carrola1/SpaceCenter/README.md

# Space_Center

## Lessons Learned
- Need to have GCC compiler optimization turned ON (optimize for size) for audio to work
-  tsl_user.h does not appear to be updating with Code Generation. Had to manually set Channel IOs definition (line 51)
