carrola1/SpaceCenter/Hardware/HLA_BOM.ods

Part # | Part Description | Qty | Cost Per | Cost Total | Notes
N/A | 3D Printed Star | 20 | $0.00 | $0.00
N/A | 3D Printed Rocket | 8 | $0.00 | $0.00
 | Push Button | 2 |  | $0.00
 | Toggle Switch |  |  | $0.00
N/A | Main PCBA | 1 | $124.00 | $124.00 | PCB + Components + Assembly
N/A | Touch PCBA | 30 | $1.13 | $34.00
N/A | Power Supply | 1 | $14.99 | $14.99 | Need 5-6A supply (184 LEDs at 20-30mA max each) Amazon: Aclorol 5V 6A 30W Power Supply
A05SR05SR30K305A | Touch Cables | 36 | $1.54 | $55.44 | Digi-key
J-Link EDU MINI | Programmer | 1 | $20.35 | $20.35
N/A | LED strip 144 LED/m | 1 | $21.00 | $21.00 | BTF-LIGHTING WS2812B RGB 5050SMD Individual Addressable 3.3FT
SK6812 | NeoPixels | 100 | $0.40 | $40.00 | Digi-key 1528-2388-ND (100 pack)
SRSS-TB(LF)(SN) | JST 5-POS Connectors | 100 | $0.40 | $40.00 | EBay. $32 + $8 shipping
3489 | Red arcade button with LED | 1 | $2.50 | $2.50 | Adafruit
3490 | Blue arcade button with LED | 1 | $2.50 | $2.50 | Adafruit
1314 | 3” speaker 4 ohm 3W | 2 | $1.95 | $3.90 | Adafruit
 |  |  | TOTAL | $358.68
