carrola1/SpaceCenter/Hardware/HLA_BOM.xlsx

Part # | Part Description | Qty | Cost Per | Cost Total | Notes
N/A | 3D Printed Star | 20 | $0.00 | $0.00
N/A | 3D Printed Rocket | 8 | $0.00 | $0.00
 | Push Button | 2 |  | $0.00
 | Toggle Switch |  |  | $0.00
N/A | Main PCBA | 1 | $124.00 | $124.00 | PCB + Components + Assembly
N/A | Touch PCBA | 20 |  | $0.00
N/A | LED Strip PCBA | 4 |  | $0.00
N/A | Power Supply | 1 | $14.99 | $14.99 | Need 5-6A supply (184 LEDs at 20-30mA max each) Amazon: Aclorol 5V 6A 30W Power Supply
A05SR05SR30K305B | Touch Cables | 32 | $1.52 | $48.64 | Digi-key
J-Link EDU MINI | Programmer | 1 | $20.35 | $20.35
LED Strip |  |  |  | $0.00 | 144 LEDs per meter. Need 128 LEDs total
 |  |  | TOTAL | $207.98
