carrola1/SpaceCenter/Hardware/SpaceCenter_MainBoard_KiCAD/SpaceCenter_MainBoard_BOM.xlsx

Item | Ref Des | Qty | Part # | Digi-key Part # | Value/Description | Package | Type | Instructions | DigiKey Cost (Each) | DigiKey Cost (Total)
1 | J6,J7,J8,J9,J10,J11,J12,J13,J14,J15,J16,J17,J18,J19,J20,J21,J22,J23,J24,J25,J26,J27,J28,J29,J30,J31,J32,J33, J34, J35,J36,J37,J38,J39,J40,J41 | 36 | DO NOT POPULATE | DO NOT POPULATE | Conn_01x05_Male | JST_SH_BM05B-SRSS-TB_1x05-1MP_P1.00mm_Vertical | SMD | DO NOT POPULATE | $0.73 | $26.28
2 | C1 | 1 | Basic | N/A | Ceramic 100u, 6.3V +/-20% or better | C_1206_3216Metric | SMD |  | $0.10 | $0.10
3 | C2,C7,C22,C23 | 4 | Basic | N/A | Ceramic 10u, 6.3V +/-20% or better | C_0603_1608Metric | SMD |  | $0.10 | $0.40
4 | C3 | 1 | Basic | N/A | Ceramic 1u, 6.3V +/-20% or better | C_0603_1608Metric | SMD |  | $0.10 | $0.10
5 | C4,C5,C6,C8,C9,C11,C12,C13,C14,C15,C16,C17,C18, C19,C20,C21,C24,C25,C26,C27 | 20 | Basic | N/A | Ceramic 0.1u 50V +/-10% or better | C_0603_1608Metric | SMD |  | $0.10 | $2.00
6 | C10 | 1 | Basic | N/A | Ceramic 0.01u 50V +/-10% or better | C_0603_1608Metric | SMD |  | $0.10 | $0.10
7 | D1 | 1 | LTST-C191KGKT | 160-1446-1-ND | LED | LED_0603_1608Metric | SMD |  | $0.26 | $0.26
8 | H1,H2,H3,H4 | 4 | N/A | N/A | MountingHole | MountingHole_3.2mm_M3 | SMD |  | N/A | N/A
9 | J1 | 1 | PJ-102AH | CP-102AH-ND | Barrel_Jack_Switch | BarrelJack_CUI_PJ-102AH_Horizontal | SMD |  | $0.76 | $0.76
10 | J2 | 1 | 20021121-00010C4LF | 609-3695-1-ND | Conn_ARM_JTAG_SWD_10 | PinHeader_2x05_P1.27mm_Vertical_SMD | SMD |  | $0.83 | $0.83
11 | J3 | 1 | DM3AT-SF-PEJM5 | HR1964CT-ND | Micro_SD_Card_Det_Hirose_DM3AT | microSD_HC_Hirose_DM3AT-SF-PEJM5 | SMD |  | $2.50 | $2.50
12 | J4,J5 | 2 | 282834-2 | A98333-ND | Screw_Terminal_01x02 | TerminalBlock_TE_282834-2_1x02_P2.54mm_Horizontal | THT | Screw terminals face out (toward edge of PCB) | $1.27 | $2.54
13 | J42 | 1 | 61300211121 | 732-5315-ND | Conn_01x02_Male | PinHeader_1x02_P2.54mm_Vertical | THT | Equivalent part # is acceptable | $0.13 | $0.13
14 | Q1,Q2 | 2 | DMG1012T-7 | DMG1012T-7DICT-ND | MOSFET N-CH 20V 630MA | SOT-523 | SMD |  | $0.31 | $0.62
15 | R1,R4,R6,R21,R23,R24,R26,R27 | 8 | Basic | N/A | 10k | R_0603_1608Metric | SMD |  | $0.10 | $0.80
16 | R2 | 1 | Basic | N/A | 100k | R_0603_1608Metric | SMD |  | $0.10 | $0.10
17 | R3,R5,R12,R13,R14,R15 | 6 | DO NOT POPULATE | N/A | DNP | R_0603_1608Metric | SMD | DO NOT POPULATE | $0.10 | $0.60
18 | R7,R22,R25 | 3 | Basic | N/A | 121 | R_0603_1608Metric | SMD |  | $0.10 | $0.30
19 | R8,R9,R10,R11,R18,R19,R20 | 7 | Basic | N/A | 33.2 | R_0603_1608Metric | SMD |  | $0.10 | $0.70
20 | R16,R17 | 2 | Basic | N/A | 200k | R_0603_1608Metric | SMD |  | $0.10 | $0.20
21 | TP1,TP2,TP3,TP4,TP5,TP6,TP7,TP8 | 8 | DO NOT POPULATE | N/A | TestPoint | TestPoint_Keystone_5019_Minature | SMD | DO NOT POPULATE | $0.10 | $0.80
22 | U1 | 1 | MIC5205-3.3YM5-TR | 576-1259-1-ND | IC REG LINEAR 3.3V 150MA | SOT-23-5 | SMD |  | $0.42 | $0.42
23 | U2 | 1 | STM32L072VBT6 | 497-18582-ND | IC MCU 32BIT 128KB FLASH | LQFP-100_14x14mm_P0.5mm | SMD |  | $6.03 | $6.03
24 | U3,U4 | 2 | MAX98357AETE+T | MAX98357AETE+TCT-ND | IC AMP CLASS D MONO 3.2W | QFN50P300X300X80-17N | SMD |  | $2.44 | $4.88
25 | U5,U6 | 2 | SN74LVC2T45DCUR | 296-17014-1-ND | SN74LVC2T45DCUR | VSSOP-8_2.4x2.1mm_P0.5mm | SMD |  | $0.63 | $1.26
 |  |  |  |  |  |  |  |  |  | $52.71
 |  | 60
