carrola1/SpaceCenter/Hardware/3D Prints/SpaceCenter Rocket.stl

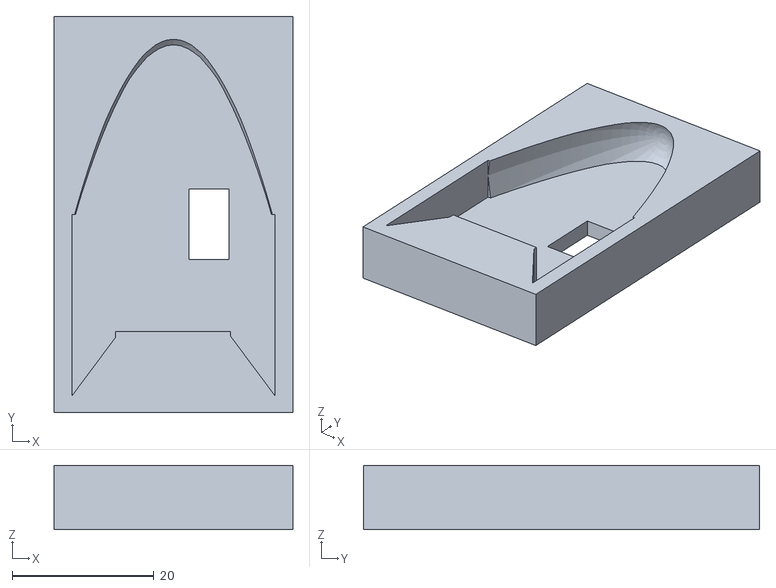
[picture p1: CAD file, 2021-08-10]
Hardware/3D Prints/SpaceCenter Rocket.stl
33.7 x 55.9 x 9.07
