carrola1/SpaceCenter/Hardware/SpaceCenter_TouchBoard_KiCAD_Rev2/SpaceCenter_TouchBoard_KiCAD.step

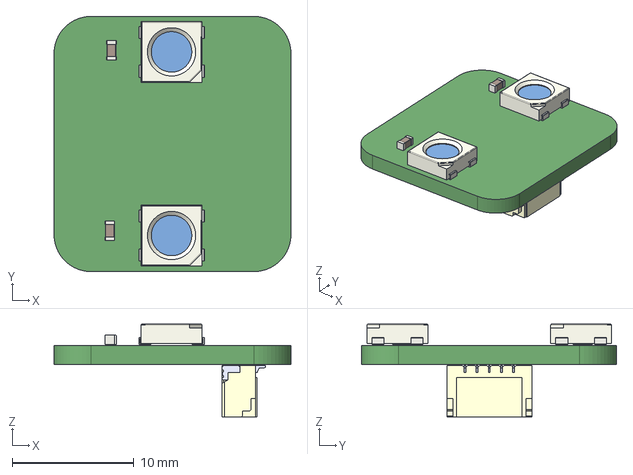
[picture p2: CAD file, 2021-05-17]
Hardware/SpaceCenter_TouchBoard_KiCAD_Rev2/SpaceCenter_TouchBoard_KiCAD.step
19.5 x 21.0 x 7.65 mm
