carrola1/SpaceCenter/Hardware/3D Prints/SpaceCenter Rocket Tall.stl

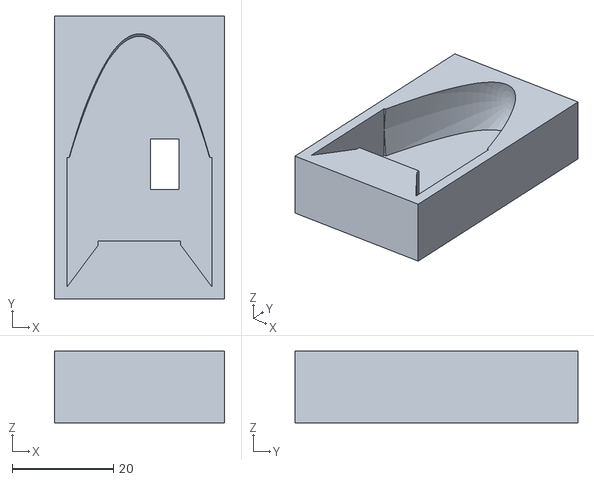
[picture p3: CAD file, 2021-08-10]
Hardware/3D Prints/SpaceCenter Rocket Tall.stl
33.7 x 55.9 x 14.1
