carrola1/SpaceCenter/Hardware/3D Prints/Space Center Star.3mf

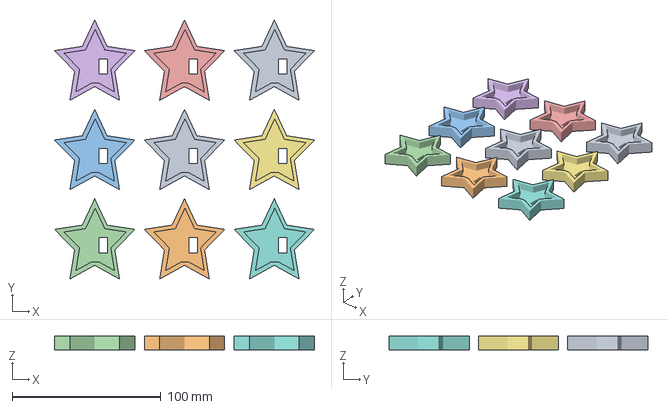
[picture p5: CAD file, 2021-06-10]
Hardware/3D Prints/Space Center Star.3mf
174.5 x 173.9 x 9.07 mm
