carrola1/SpaceCenter/Hardware/3D Prints/SpaceCenter Rocket Stream LED Holder.stl

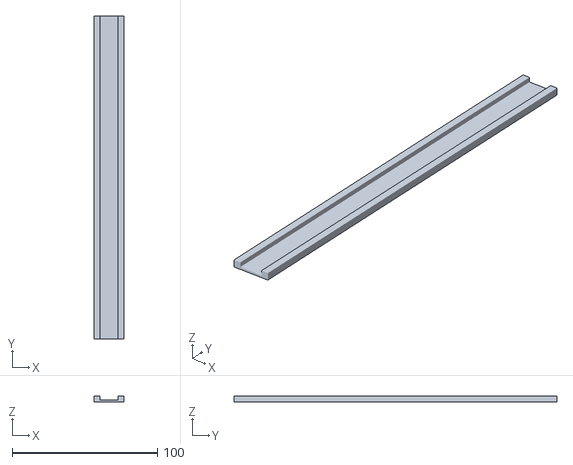
[picture p6: CAD file, 2021-06-10]
Hardware/3D Prints/SpaceCenter Rocket Stream LED Holder.stl
20.3 x 222.2 x 3.81
