carrola1/SpaceCenter/(list of files, cad)

Other CAD files:
Hardware/3D Prints/Space Center Star.stl
