carrola1/SpaceCenter/Hardware/SpaceCenter_TouchBoard_KiCAD_Rev2/SpaceCenter_TouchBoard_KiCAD.kicad_pcb

## KiCad design Hardware/SpaceCenter_TouchBoard_KiCAD_Rev2/SpaceCenter_TouchBoard_KiCAD.kicad_pcb (2021-10-01)

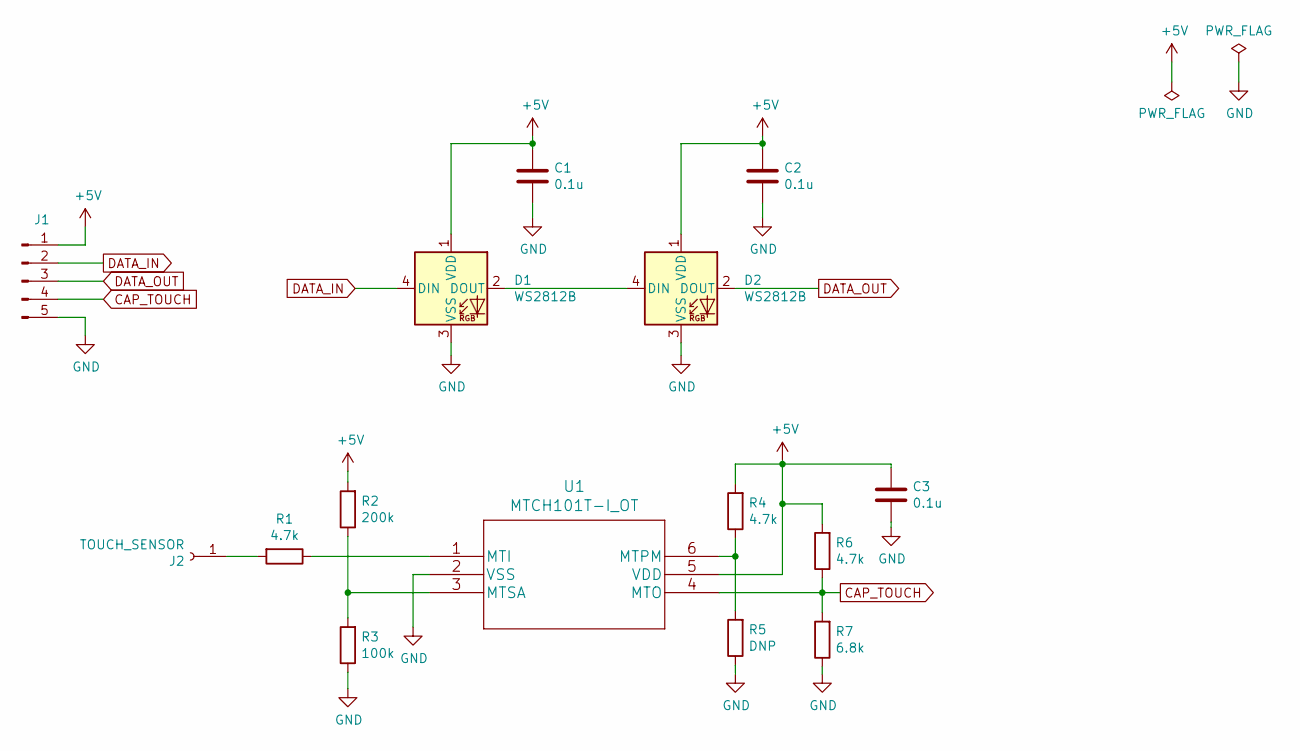
[picture p7: schematic SpaceCenter_TouchBoard_KiCAD.sch]

Parts:
C1, C2, C3: 0.1u; C_0402_1005Metric_Pad0.74x0.62mm_HandSolder
D1, D2: WS2812B; LED_WS2812B_PLCC4_5.0x5.0mm_P3.2mm
J1: Conn_01x05_Male; JST_SH_BM05B-SRSS-TB_1x05-1MP_P1.00mm_Vertical
J2: TOUCH_SENSOR; SolderWirePad_1x01_SMD_5x10mm
R1, R4, R6: 4.7k; R_0402_1005Metric_Pad0.72x0.64mm_HandSolder
R2: 200k; R_0402_1005Metric_Pad0.72x0.64mm_HandSolder
R3: 100k; R_0402_1005Metric_Pad0.72x0.64mm_HandSolder
R5: DNP; R_0402_1005Metric_Pad0.72x0.64mm_HandSolder
R7: 6.8k; R_0402_1005Metric_Pad0.72x0.64mm_HandSolder
U1: MTCH101T-I_OT; MTCH101T-I&slash_OT

Connections:
+5V: C1.1, C2.1, C3.1, D1.1 (VDD), D2.1 (VDD), J1.1, R2.2, R4.2, R6.2, U1.5 (VDD)
CAP_TOUCH: J1.4, R6.1, R7.2, U1.4 (MTO)
DATA_IN: D1.4 (DIN), J1.2
DATA_OUT: D2.2 (DOUT), J1.3
GND: C1.2, C2.2, C3.2, D1.3 (VSS), D2.3 (VSS), J1.5, R3.1, R5.1, R7.1, U1.2 (VSS)
unnamed: D1.2 (DOUT), D2.4 (DIN)
unnamed: J2.1, R1.2
unnamed: R1.1, U1.1 (MTI)
unnamed: R2.1, R3.2, U1.3 (MTSA)
unnamed: R4.1, R5.2, U1.6 (MTPM)

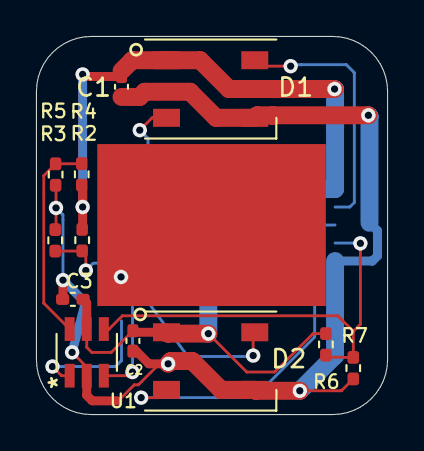
[picture p8: board SpaceCenter_TouchBoard_KiCAD.kicad_pcb from above]

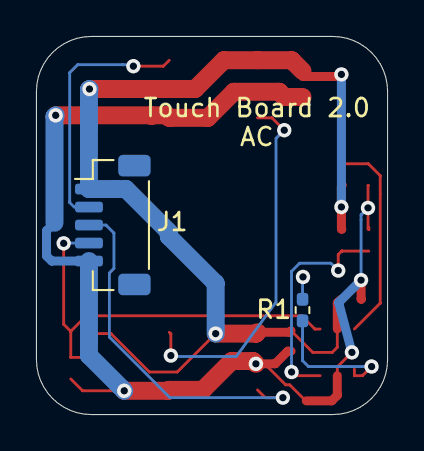
[picture p9: board SpaceCenter_TouchBoard_KiCAD.kicad_pcb from below]

Board: 2 copper layers, 19.5 x 21.0 mm, 15 parts (2 on the bottom side), 10 nets.
