carrola1/SpaceCenter/Hardware/SpaceCenter_MainBoard_KiCAD/SpaceCenter_MainBoard_KiCAD.kicad_pcb

## KiCad design Hardware/SpaceCenter_MainBoard_KiCAD/SpaceCenter_MainBoard_KiCAD.kicad_pcb (2021-02-16)

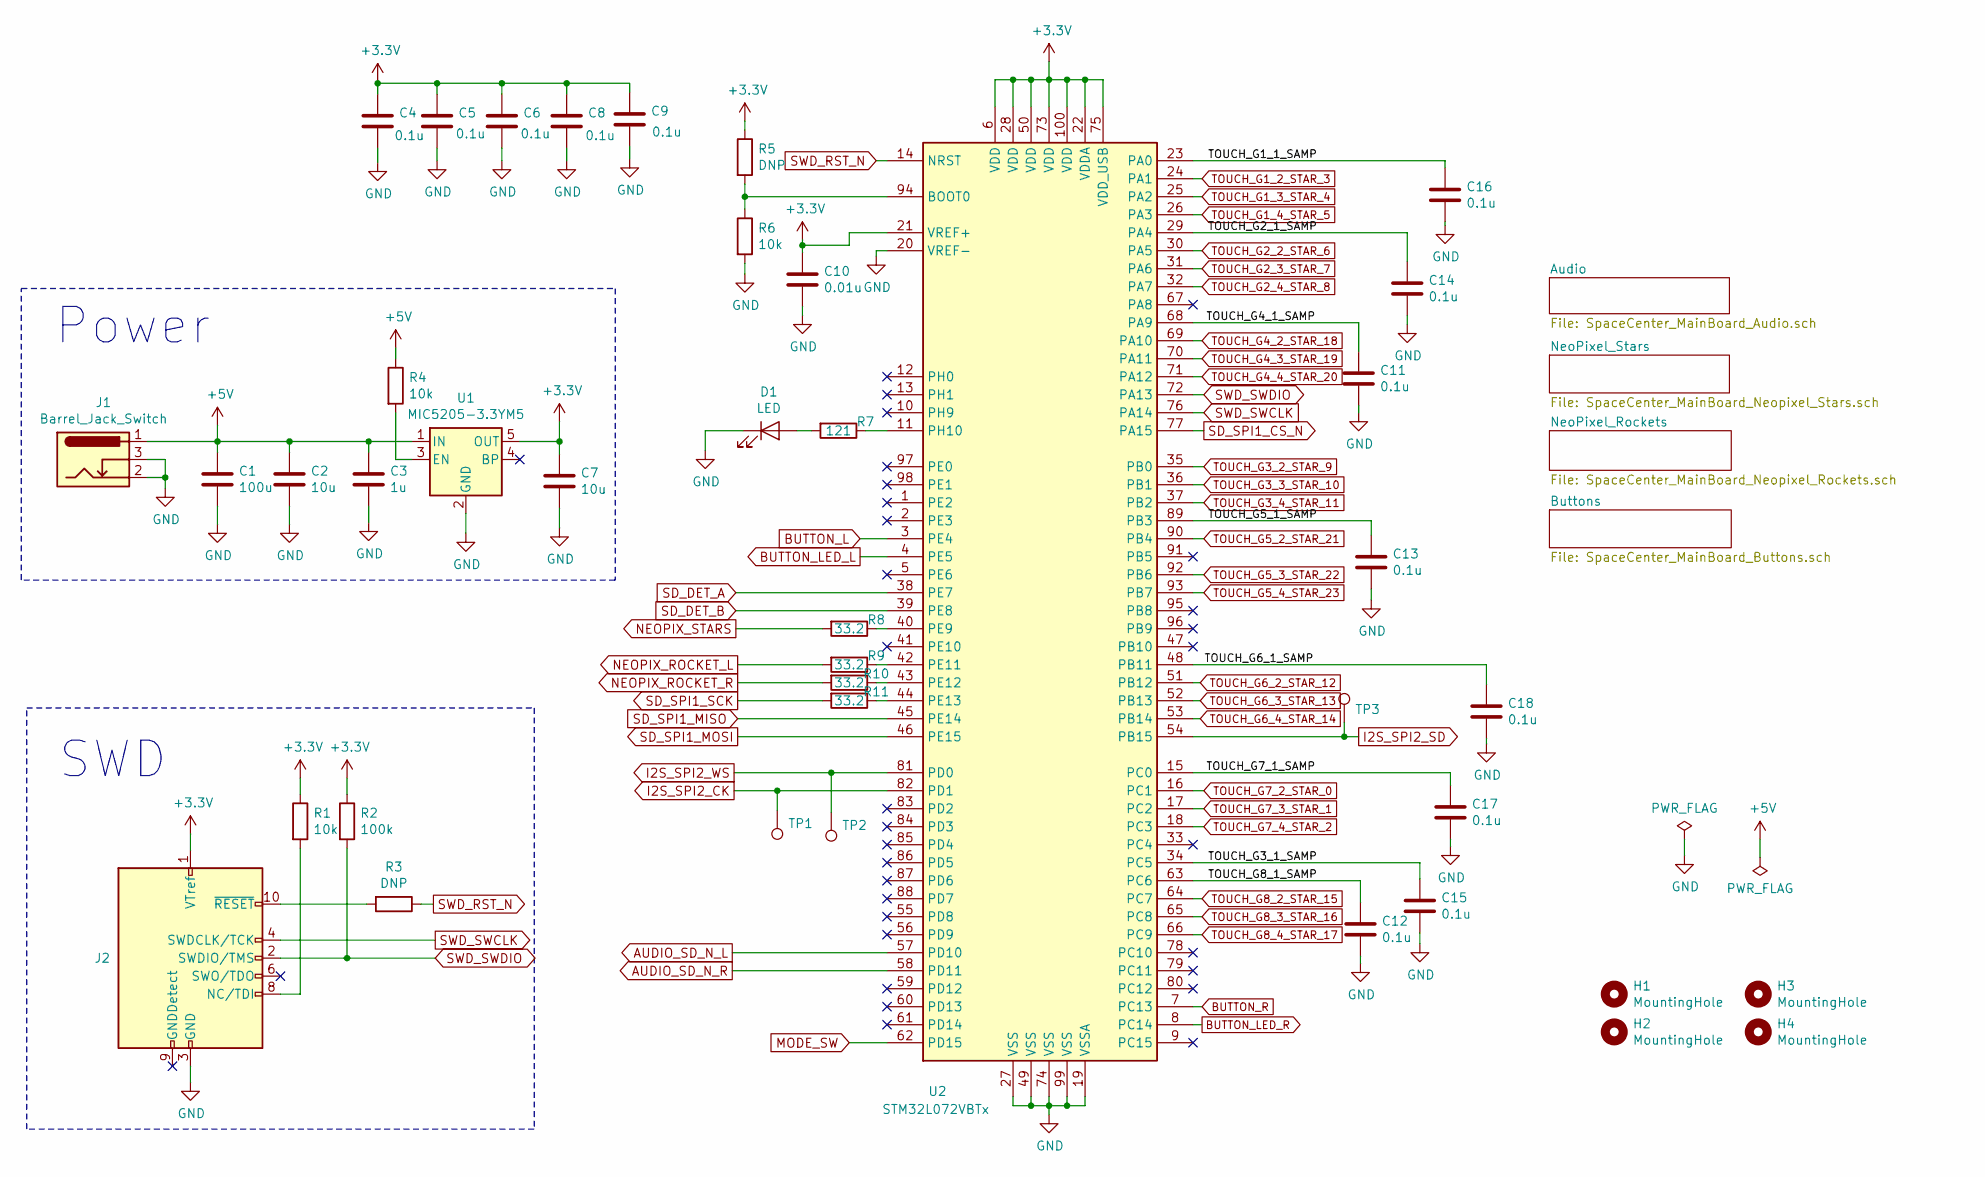
[picture p10: schematic SpaceCenter_MainBoard_KiCAD.sch]

Parts:
C1: 100u; C_1206_3216Metric_Pad1.42x1.75mm_HandSolder
C2, C7: 10u; C_0603_1608Metric_Pad1.05x0.95mm_HandSolder
C3: 1u; C_0603_1608Metric_Pad1.05x0.95mm_HandSolder
C4, C5, C6, C8, C9, C11, C12, C13, C14, C15, C16, C17, C18: 0.1u; C_0603_1608Metric_Pad1.05x0.95mm_HandSolder
C10: 0.01u; C_0603_1608Metric_Pad1.05x0.95mm_HandSolder
D1: LED; LED_0603_1608Metric_Pad1.05x0.95mm_HandSolder
H1, H2, H3, H4: MountingHole; MountingHole_3.2mm_M3
J1: Barrel_Jack_Switch; BarrelJack_CUI_PJ-102AH_Horizontal
J2: Conn_ARM_JTAG_SWD_10; PinHeader_2x05_P1.27mm_Vertical_SMD
R1, R4, R6: 10k; R_0603_1608Metric_Pad1.05x0.95mm_HandSolder
R2: 100k; R_0603_1608Metric_Pad1.05x0.95mm_HandSolder
R3, R5: DNP; R_0603_1608Metric_Pad1.05x0.95mm_HandSolder
R7: 121; R_0603_1608Metric_Pad1.05x0.95mm_HandSolder
R8, R9, R10, R11: 33.2; R_0603_1608Metric_Pad1.05x0.95mm_HandSolder
TP1, TP2, TP3: TestPoint; TestPoint_Keystone_5019_Minature
U1: MIC5205-3.3YM5; SOT-23-5
U2: STM32L072VBTx; LQFP-100_14x14mm_P0.5mm

Connections:
+3V3: C4.1, C5.1, C6.1, C7.1, C8.1, C9.1, C10.1, J2.1 (VTref), R1.1, R2.1, R5.1, U1.5 (OUT), U2.6 (VDD), U2.21 (VREF+), U2.22 (VDDA), U2.28 (VDD), U2.50 (VDD), U2.73 (VDD), U2.75 (VDD_USB), U2.100 (VDD); also elsewhere on the board
+5V: C1.1, C2.1, C3.1, J1.1, R4.1, U1.1 (IN); also elsewhere on the board
/TOUCH_G1_1_SAMP: C16.1, U2.23 (PA0)
/TOUCH_G2_1_SAMP: C14.1, U2.29 (PA4)
/TOUCH_G3_1_SAMP: C15.1, U2.34 (PC5)
/TOUCH_G4_1_SAMP: C11.1, U2.68 (PA9)
/TOUCH_G5_1_SAMP: C13.1, U2.89 (PB3)
/TOUCH_G6_1_SAMP: C18.1, U2.48 (PB11)
/TOUCH_G7_1_SAMP: C17.1, U2.15 (PC0)
/TOUCH_G8_1_SAMP: C12.1, U2.63 (PC6)
AUDIO_SD_N_L: U2.57 (PD10); also elsewhere on the board
AUDIO_SD_N_R: U2.58 (PD11); also elsewhere on the board
BUTTON_L: U2.3 (PE4); also elsewhere on the board
BUTTON_LED_L: U2.4 (PE5); also elsewhere on the board
BUTTON_LED_R: U2.8 (PC14); also elsewhere on the board
BUTTON_R: U2.7 (PC13); also elsewhere on the board
GND: C1.2, C2.2, C3.2, C4.2, C5.2, C6.2, C7.2, C8.2, C9.2, C10.2, C11.2, C12.2, C13.2, C14.2, C15.2, C16.2, C17.2, C18.2, D1.1 (K), J1.2, J1.3, J2.3 (GND), J2.5 (GND), R6.2, U1.2 (GND), U2.19 (VSSA), U2.20 (VREF-), U2.27 (VSS), U2.49 (VSS), U2.74 (VSS), U2.99 (VSS); also elsewhere on the board
I2S_SPI2_CK: TP1.1, U2.82 (PD1); also elsewhere on the board
I2S_SPI2_SD: TP3.1, U2.54 (PB15); also elsewhere on the board
I2S_SPI2_WS: TP2.1, U2.81 (PD0); also elsewhere on the board
MODE_SW: U2.62 (PD15); also elsewhere on the board
NEOPIX_ROCKET_L: R9.2; also elsewhere on the board
NEOPIX_ROCKET_R: R10.2; also elsewhere on the board
NEOPIX_STARS: R8.2; also elsewhere on the board
unnamed: D1.2 (A), R7.2
unnamed: J2.8 (NC/TDI), R1.2
unnamed: J2.10 (~RESET~), R3.2
unnamed: R4.2, U1.3 (EN)
unnamed: R5.2, R6.1, U2.94 (BOOT0)
unnamed: R7.1, U2.11 (PH10)
unnamed: R8.1, U2.40 (PE9)
unnamed: R9.1, U2.42 (PE11)
unnamed: R10.1, U2.43 (PE12)
unnamed: R11.1, U2.44 (PE13)
SD_DET_A: U2.38 (PE7); also elsewhere on the board
SD_DET_B: U2.39 (PE8); also elsewhere on the board
SD_SPI1_CS_N: U2.77 (PA15); also elsewhere on the board
SD_SPI1_MISO: U2.45 (PE14); also elsewhere on the board
SD_SPI1_MOSI: U2.46 (PE15); also elsewhere on the board
SD_SPI1_SCK: R11.2; also elsewhere on the board
SWD_RST_N: R3.1, U2.14 (NRST)
SWD_SWCLK: J2.4 (SWDCLK/TCK), U2.76 (PA14)
SWD_SWDIO: J2.2 (SWDIO/TMS), R2.2, U2.72 (PA13)
TOUCH_G1_2_STAR_3: U2.24 (PA1); also elsewhere on the board
TOUCH_G1_3_STAR_4: U2.25 (PA2); also elsewhere on the board
TOUCH_G1_4_STAR_5: U2.26 (PA3); also elsewhere on the board
TOUCH_G2_2_STAR_6: U2.30 (PA5); also elsewhere on the board
TOUCH_G2_3_STAR_7: U2.31 (PA6); also elsewhere on the board
TOUCH_G2_4_STAR_8: U2.32 (PA7); also elsewhere on the board
TOUCH_G3_2_STAR_9: U2.35 (PB0); also elsewhere on the board
TOUCH_G3_3_STAR_10: U2.36 (PB1); also elsewhere on the board
TOUCH_G3_4_STAR_11: U2.37 (PB2); also elsewhere on the board
TOUCH_G4_2_STAR_18: U2.69 (PA10); also elsewhere on the board
TOUCH_G4_3_STAR_19: U2.70 (PA11); also elsewhere on the board
TOUCH_G4_4_STAR_20: U2.71 (PA12); also elsewhere on the board
TOUCH_G5_2_STAR_21: U2.90 (PB4); also elsewhere on the board
TOUCH_G5_3_STAR_22: U2.92 (PB6); also elsewhere on the board
TOUCH_G5_4_STAR_23: U2.93 (PB7); also elsewhere on the board
TOUCH_G6_2_STAR_12: U2.51 (PB12); also elsewhere on the board
TOUCH_G6_3_STAR_13: U2.52 (PB13); also elsewhere on the board
TOUCH_G6_4_STAR_14: U2.53 (PB14); also elsewhere on the board
TOUCH_G7_2_STAR_0: U2.16 (PC1); also elsewhere on the board
TOUCH_G7_3_STAR_1: U2.17 (PC2); also elsewhere on the board
TOUCH_G7_4_STAR_2: U2.18 (PC3); also elsewhere on the board
TOUCH_G8_2_STAR_15: U2.64 (PC7); also elsewhere on the board
TOUCH_G8_3_STAR_16: U2.65 (PC8); also elsewhere on the board
TOUCH_G8_4_STAR_17: U2.66 (PC9); also elsewhere on the board

Notes on the sheet:
Power
SWD

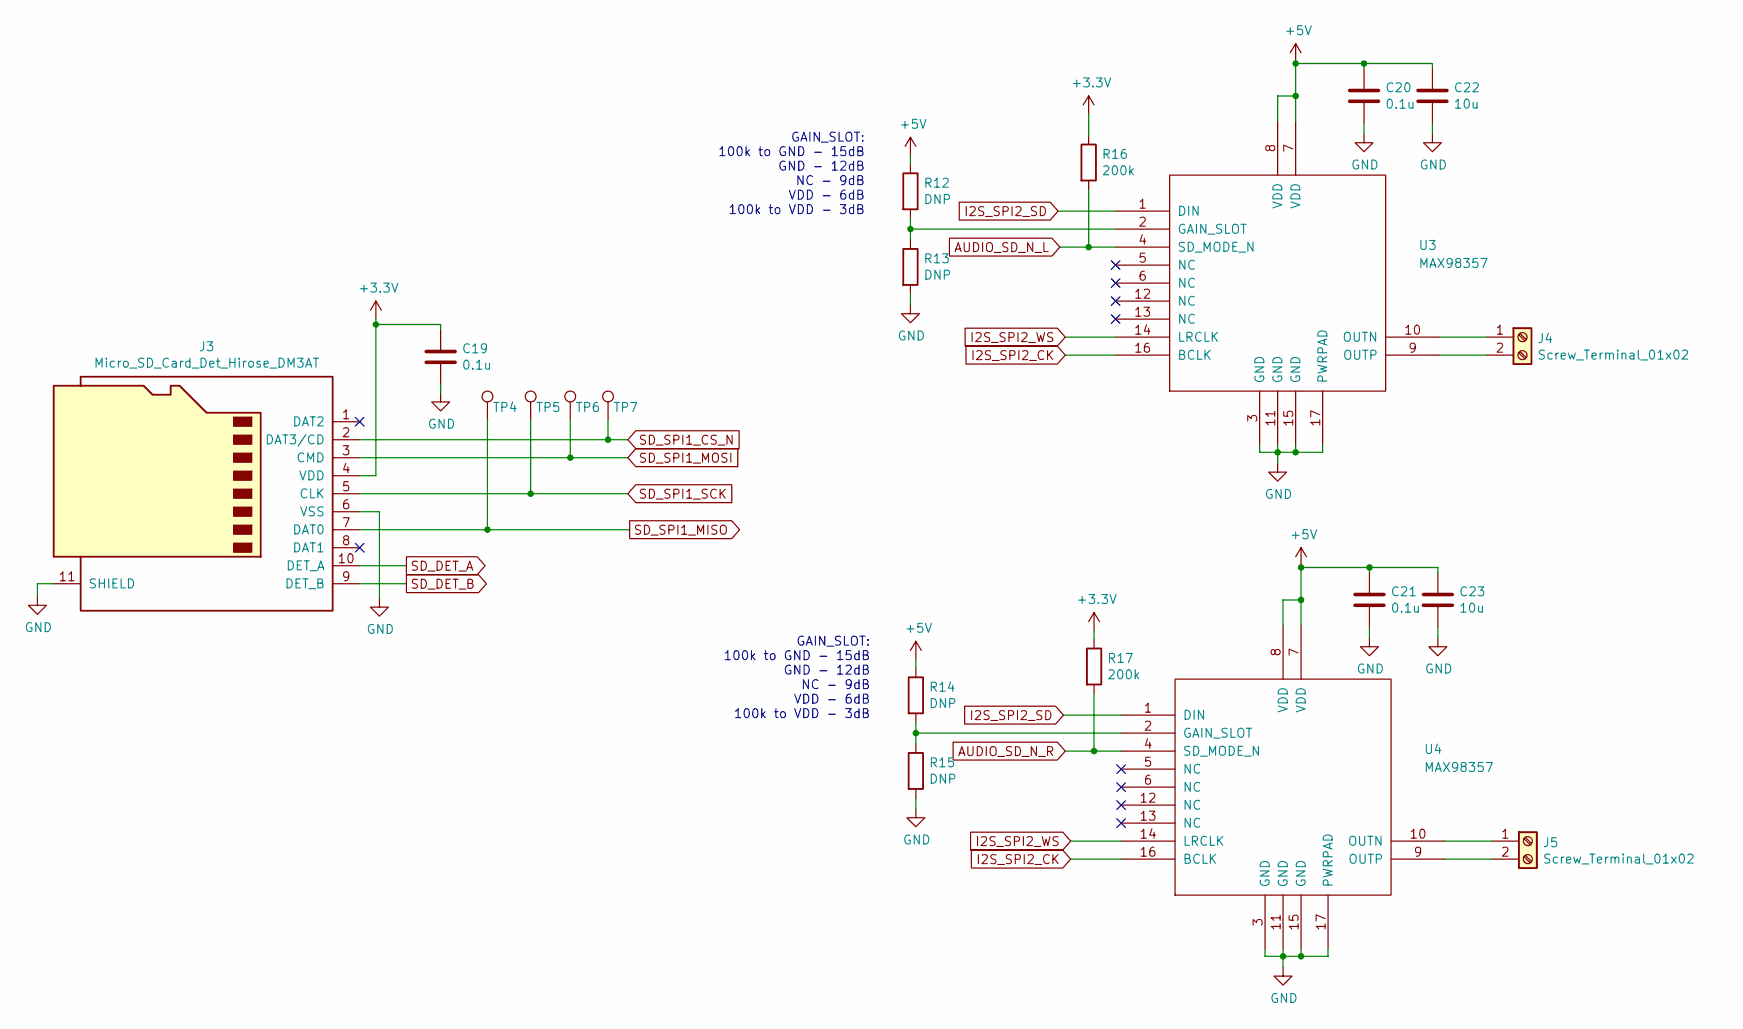
[picture p11: schematic SpaceCenter_MainBoard_Audio.sch]

Parts:
C19, C20, C21: 0.1u; C_0603_1608Metric_Pad1.05x0.95mm_HandSolder
C22, C23: 10u; C_0603_1608Metric_Pad1.05x0.95mm_HandSolder
J3: Micro_SD_Card_Det_Hirose_DM3AT; microSD_HC_Hirose_DM3AT-SF-PEJM5
J4, J5: Screw_Terminal_01x02; TerminalBlock_TE_282834-2_1x02_P2.54mm_Horizontal
R12, R13, R14, R15: DNP; R_0603_1608Metric_Pad1.05x0.95mm_HandSolder
R16, R17: 200k; R_0603_1608Metric_Pad1.05x0.95mm_HandSolder
TP4, TP5, TP6, TP7: TestPoint; TestPoint_Keystone_5019_Minature
U3, U4: MAX98357; QFN50P300X300X80-17N

Connections:
+3V3: C19.1, J3.4 (VDD), R16.1, R17.1; also elsewhere on the board
+5V: C20.1, C21.1, C22.1, C23.1, R12.1, R14.1, U3.7 (VDD), U3.8 (VDD), U4.7 (VDD), U4.8 (VDD); also elsewhere on the board
AUDIO_SD_N_L: R16.2, U3.4 (SD_MODE_N); also elsewhere on the board
AUDIO_SD_N_R: R17.2, U4.4 (SD_MODE_N); also elsewhere on the board
GND: C19.2, C20.2, C21.2, C22.2, C23.2, J3.6 (VSS), J3.11 (SHIELD), R13.2, R15.2, U3.3 (GND), U3.11 (GND), U3.15 (GND), U3.17 (PWRPAD), U4.3 (GND), U4.11 (GND), U4.15 (GND), U4.17 (PWRPAD); also elsewhere on the board
I2S_SPI2_CK: U3.16 (BCLK), U4.16 (BCLK); also elsewhere on the board
I2S_SPI2_SD: U3.1 (DIN), U4.1 (DIN); also elsewhere on the board
I2S_SPI2_WS: U3.14 (LRCLK), U4.14 (LRCLK); also elsewhere on the board
unnamed: J4.1, U3.10 (OUTN)
unnamed: J4.2, U3.9 (OUTP)
unnamed: J5.1, U4.10 (OUTN)
unnamed: J5.2, U4.9 (OUTP)
unnamed: R12.2, R13.1, U3.2 (GAIN_SLOT)
unnamed: R14.2, R15.1, U4.2 (GAIN_SLOT)
SD_DET_A: J3.10 (DET_A); also elsewhere on the board
SD_DET_B: J3.9 (DET_B); also elsewhere on the board
SD_SPI1_CS_N: J3.2 (DAT3/CD), TP7.1; also elsewhere on the board
SD_SPI1_MISO: J3.7 (DAT0), TP4.1; also elsewhere on the board
SD_SPI1_MOSI: J3.3 (CMD), TP6.1; also elsewhere on the board
SD_SPI1_SCK: J3.5 (CLK), TP5.1; also elsewhere on the board

Notes on the sheet:
GAIN_SLOT: 100k to GND - 15dB GND - 12dB NC - 9dB VDD - 6dB 100k to VDD - 3dB

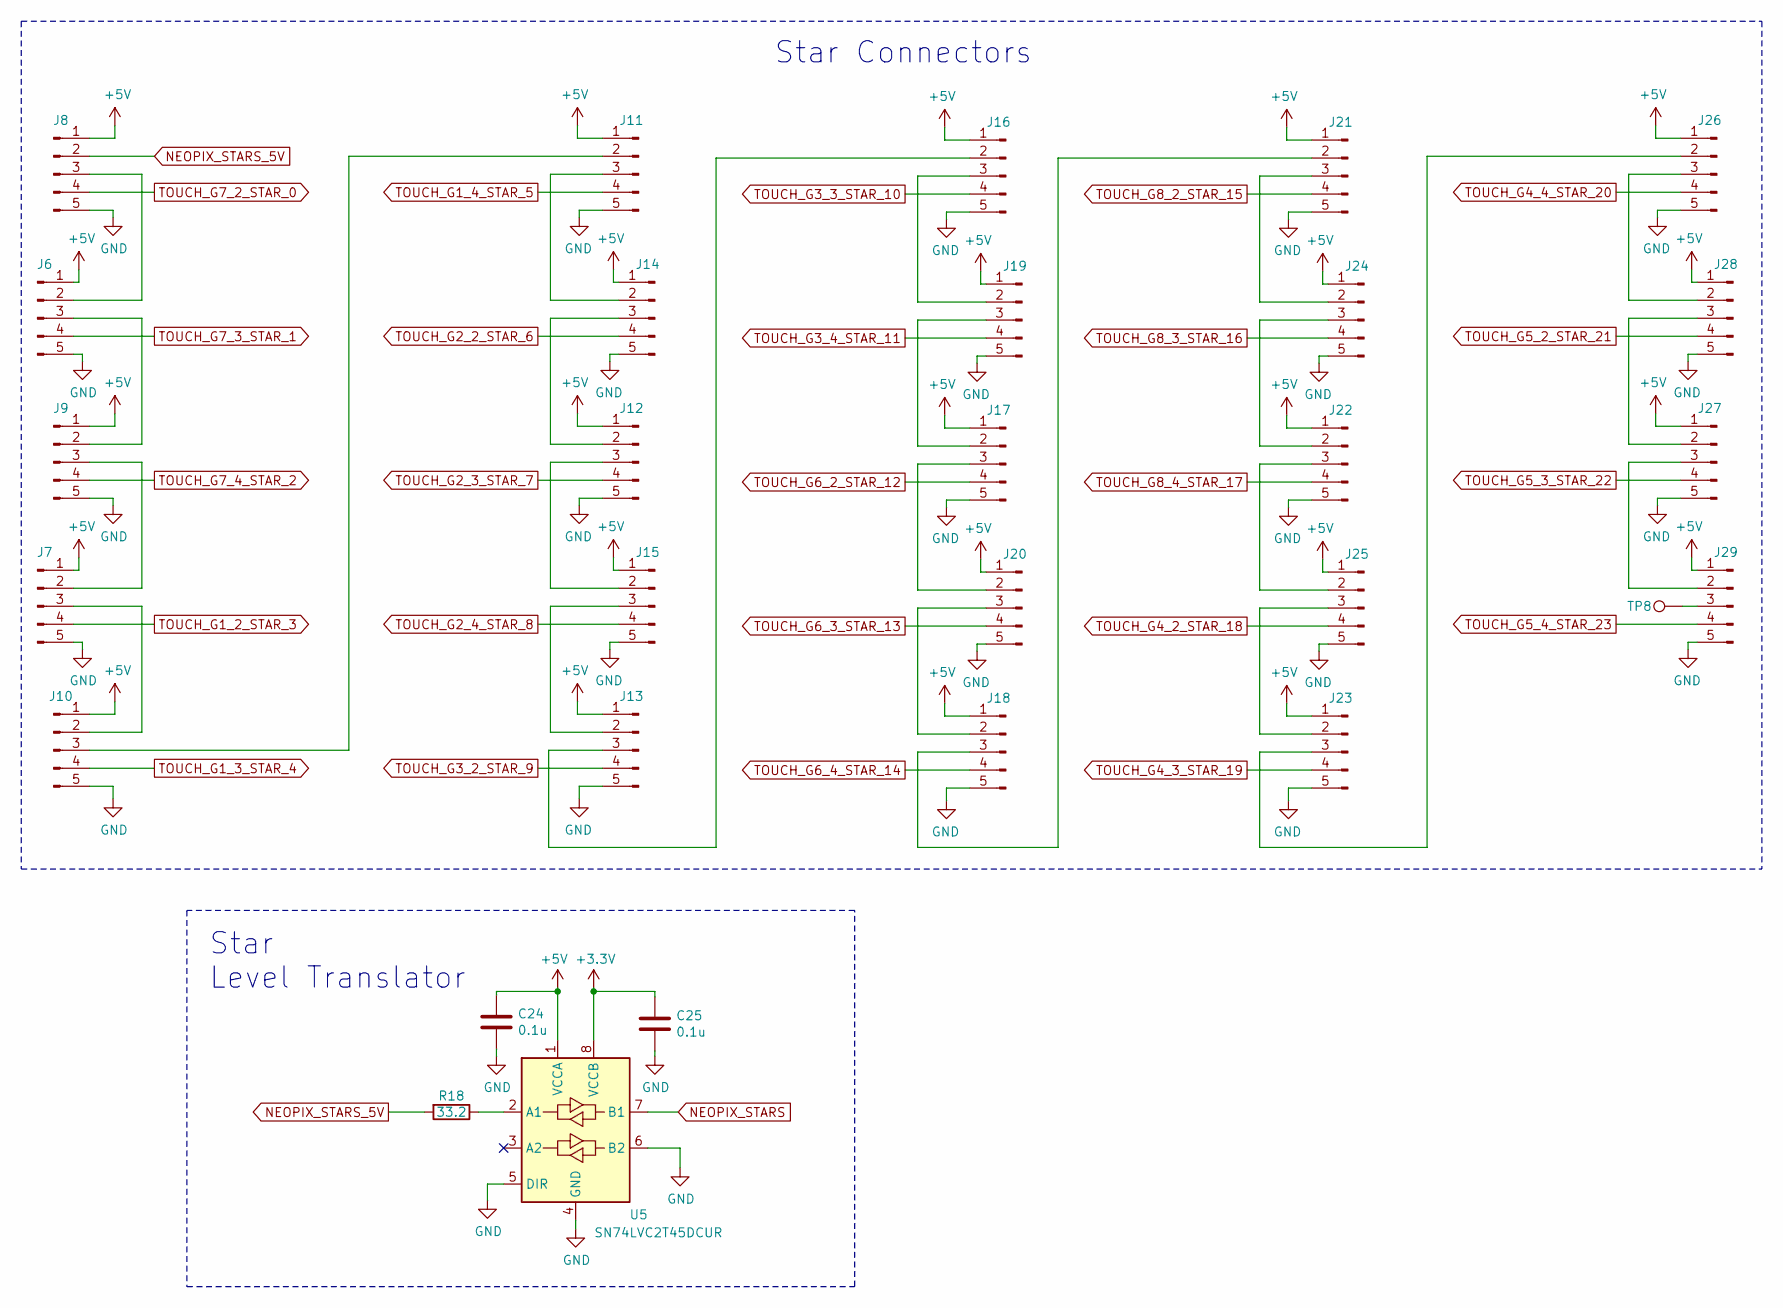
[picture p12: schematic SpaceCenter_MainBoard_Neopixel_Stars.sch]

Parts:
C24, C25: 0.1u; C_0603_1608Metric_Pad1.05x0.95mm_HandSolder
J6, J7, J8, J9, J10, J11, J12, J13, J14, J15, J16, J17, J18, J19, J20, J21, J22, J23, J24, J25, J26, J27, J28, J29: Conn_01x05_Male; JST_SH_BM05B-SRSS-TB_1x05-1MP_P1.00mm_Vertical
R18: 33.2; R_0603_1608Metric_Pad1.05x0.95mm_HandSolder
TP8: TestPoint; TestPoint_Keystone_5019_Minature
U5: SN74LVC2T45DCUR; VSSOP-8_2.4x2.1mm_P0.5mm

Connections:
+3V3: C25.1, U5.8 (VCCB); also elsewhere on the board
+5V: C24.1, J6.1, J7.1, J8.1, J9.1, J10.1, J11.1, J12.1, J13.1, J14.1, J15.1, J16.1, J17.1, J18.1, J19.1, J20.1, J21.1, J22.1, J23.1, J24.1, J25.1, J26.1, J27.1, J28.1, J29.1, U5.1 (VCCA); also elsewhere on the board
GND: C24.2, C25.2, J6.5, J7.5, J8.5, J9.5, J10.5, J11.5, J12.5, J13.5, J14.5, J15.5, J16.5, J17.5, J18.5, J19.5, J20.5, J21.5, J22.5, J23.5, J24.5, J25.5, J26.5, J27.5, J28.5, J29.5, U5.4 (GND), U5.5 (DIR), U5.6 (B2); also elsewhere on the board
NEOPIX_STARS: U5.7 (B1); also elsewhere on the board
NEOPIX_STARS_5V: J8.2, R18.2
unnamed: J6.2, J8.3
unnamed: J6.3, J9.2
unnamed: J7.2, J9.3
unnamed: J7.3, J10.2
unnamed: J10.3, J11.2
unnamed: J11.3, J14.2
unnamed: J12.2, J14.3
unnamed: J12.3, J15.2
unnamed: J13.2, J15.3
unnamed: J13.3, J16.2
unnamed: J16.3, J19.2
unnamed: J17.2, J19.3
unnamed: J17.3, J20.2
unnamed: J18.2, J20.3
unnamed: J18.3, J21.2
unnamed: J21.3, J24.2
unnamed: J22.2, J24.3
unnamed: J22.3, J25.2
unnamed: J23.2, J25.3
unnamed: J23.3, J26.2
unnamed: J26.3, J28.2
unnamed: J27.2, J28.3
unnamed: J27.3, J29.2
unnamed: J29.3, TP8.1
unnamed: R18.1, U5.2 (A1)
TOUCH_G1_2_STAR_3: J7.4; also elsewhere on the board
TOUCH_G1_3_STAR_4: J10.4; also elsewhere on the board
TOUCH_G1_4_STAR_5: J11.4; also elsewhere on the board
TOUCH_G2_2_STAR_6: J14.4; also elsewhere on the board
TOUCH_G2_3_STAR_7: J12.4; also elsewhere on the board
TOUCH_G2_4_STAR_8: J15.4; also elsewhere on the board
TOUCH_G3_2_STAR_9: J13.4; also elsewhere on the board
TOUCH_G3_3_STAR_10: J16.4; also elsewhere on the board
TOUCH_G3_4_STAR_11: J19.4; also elsewhere on the board
TOUCH_G4_2_STAR_18: J25.4; also elsewhere on the board
TOUCH_G4_3_STAR_19: J23.4; also elsewhere on the board
TOUCH_G4_4_STAR_20: J26.4; also elsewhere on the board
TOUCH_G5_2_STAR_21: J28.4; also elsewhere on the board
TOUCH_G5_3_STAR_22: J27.4; also elsewhere on the board
TOUCH_G5_4_STAR_23: J29.4; also elsewhere on the board
TOUCH_G6_2_STAR_12: J17.4; also elsewhere on the board
TOUCH_G6_3_STAR_13: J20.4; also elsewhere on the board
TOUCH_G6_4_STAR_14: J18.4; also elsewhere on the board
TOUCH_G7_2_STAR_0: J8.4; also elsewhere on the board
TOUCH_G7_3_STAR_1: J6.4; also elsewhere on the board
TOUCH_G7_4_STAR_2: J9.4; also elsewhere on the board
TOUCH_G8_2_STAR_15: J21.4; also elsewhere on the board
TOUCH_G8_3_STAR_16: J24.4; also elsewhere on the board
TOUCH_G8_4_STAR_17: J22.4; also elsewhere on the board

Notes on the sheet:
Star Level Translator
Star Connectors

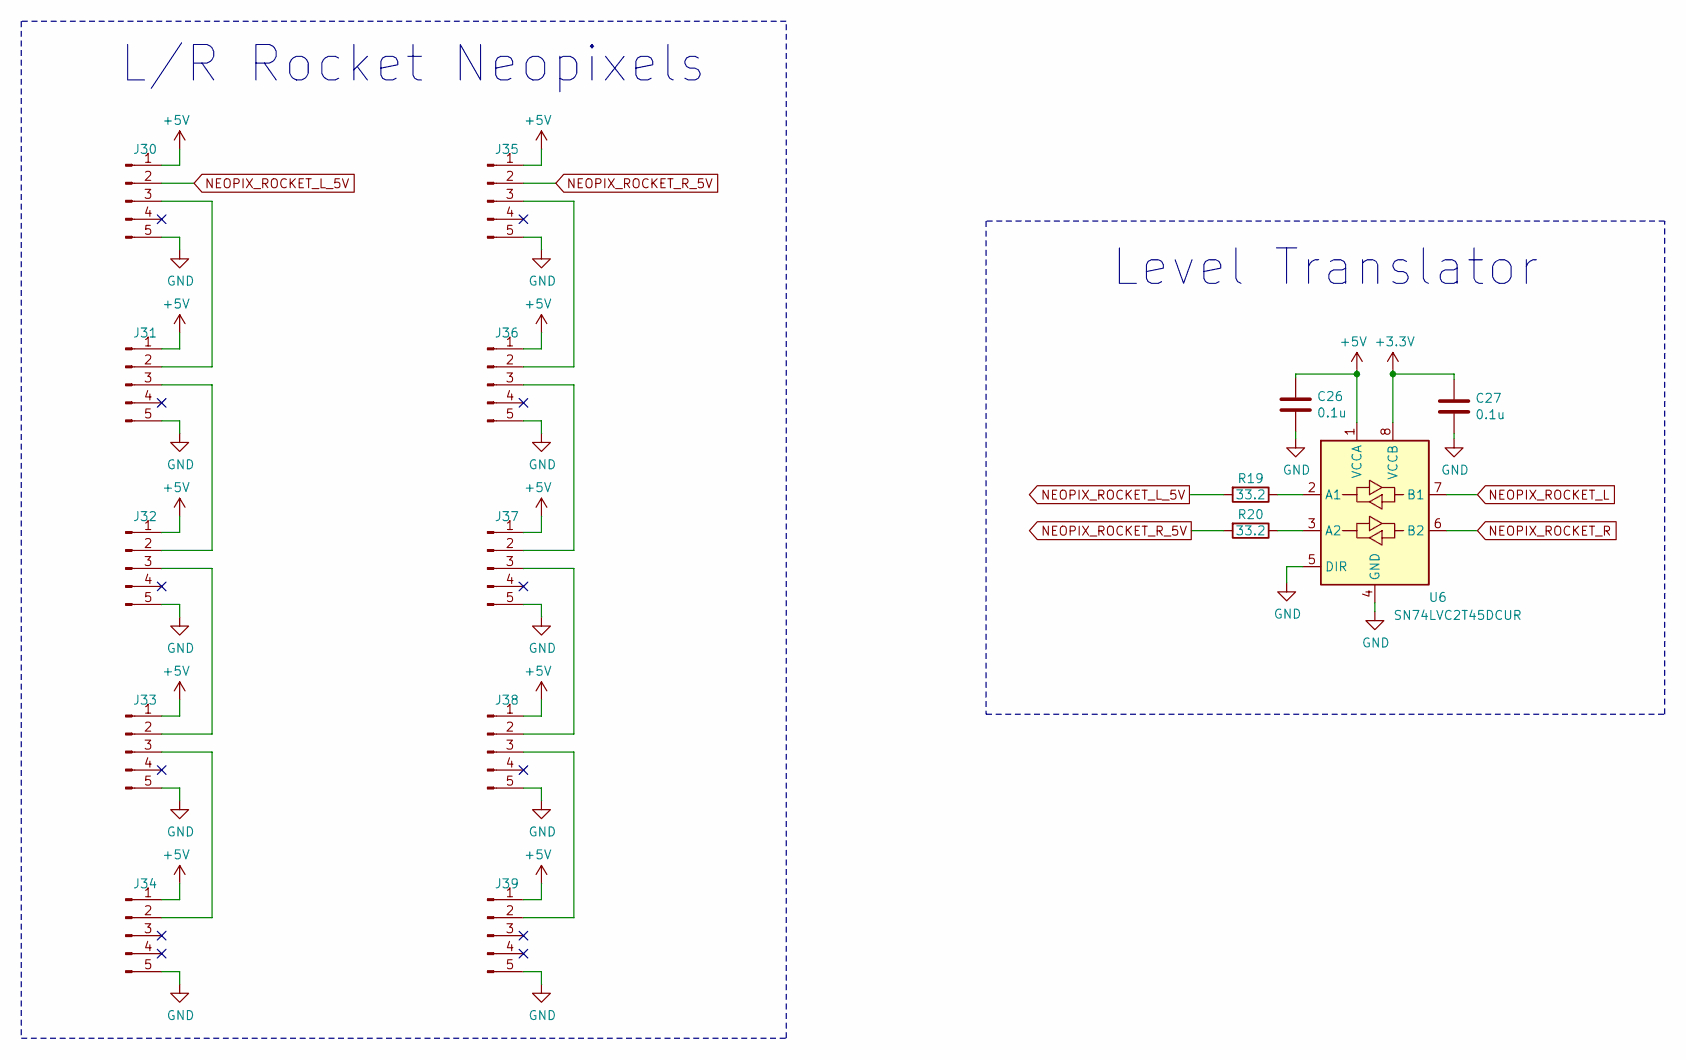
[picture p13: schematic SpaceCenter_MainBoard_Neopixel_Rockets.sch]

Parts:
C26, C27: 0.1u; C_0603_1608Metric_Pad1.05x0.95mm_HandSolder
J30, J31, J32, J33, J34, J35, J36, J37, J38, J39: Conn_01x05_Male; JST_SH_BM05B-SRSS-TB_1x05-1MP_P1.00mm_Vertical
R19, R20: 33.2; R_0603_1608Metric_Pad1.05x0.95mm_HandSolder
U6: SN74LVC2T45DCUR; VSSOP-8_2.4x2.1mm_P0.5mm

Connections:
+3V3: C27.1, U6.8 (VCCB); also elsewhere on the board
+5V: C26.1, J30.1, J31.1, J32.1, J33.1, J34.1, J35.1, J36.1, J37.1, J38.1, J39.1, U6.1 (VCCA); also elsewhere on the board
GND: C26.2, C27.2, J30.5, J31.5, J32.5, J33.5, J34.5, J35.5, J36.5, J37.5, J38.5, J39.5, U6.4 (GND), U6.5 (DIR); also elsewhere on the board
NEOPIX_ROCKET_L: U6.7 (B1); also elsewhere on the board
NEOPIX_ROCKET_L_5V: J30.2, R19.2
NEOPIX_ROCKET_R: U6.6 (B2); also elsewhere on the board
NEOPIX_ROCKET_R_5V: J35.2, R20.2
unnamed: J30.3, J31.2
unnamed: J31.3, J32.2
unnamed: J32.3, J33.2
unnamed: J33.3, J34.2
unnamed: J35.3, J36.2
unnamed: J36.3, J37.2
unnamed: J37.3, J38.2
unnamed: J38.3, J39.2
unnamed: R19.1, U6.2 (A1)
unnamed: R20.1, U6.3 (A2)

Notes on the sheet:
L/R Rocket Neopixels
Level Translator

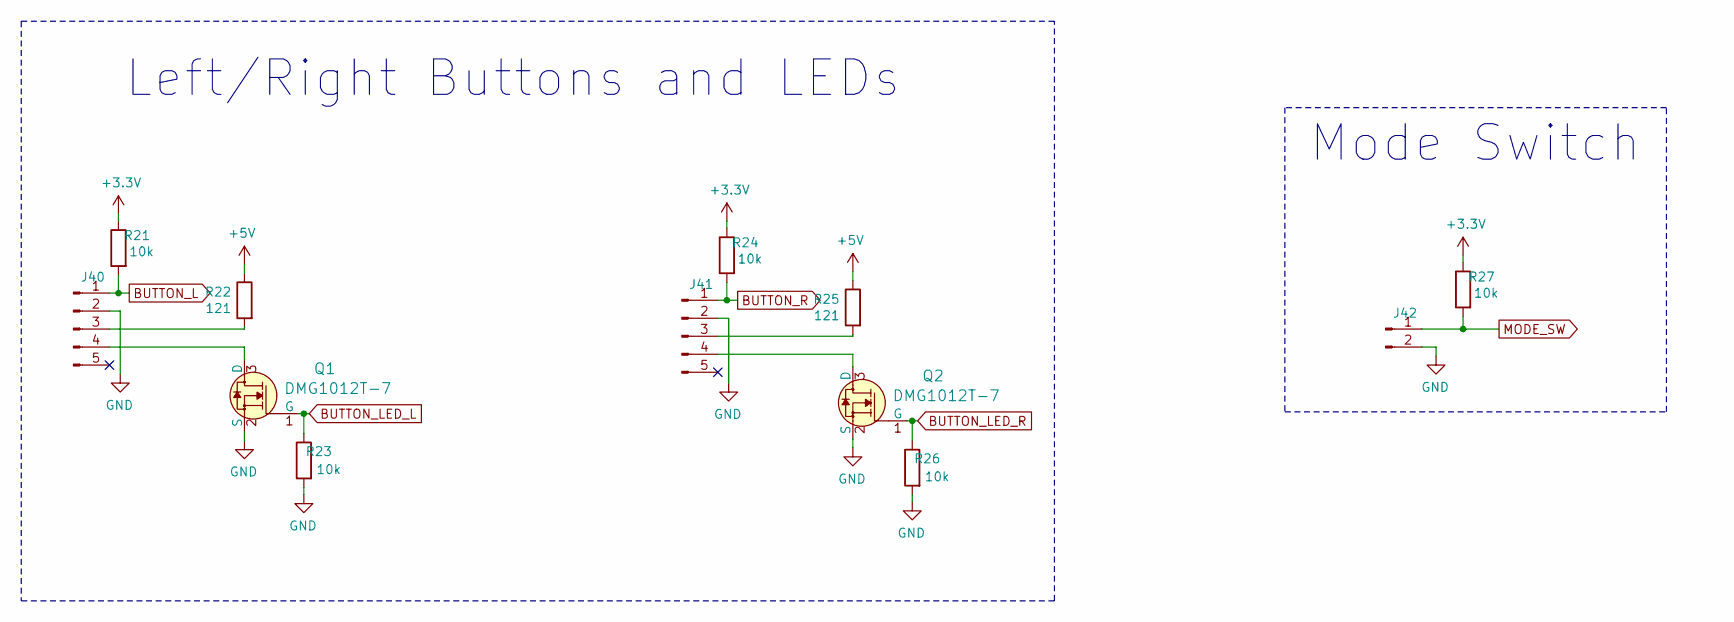
[picture p14: schematic SpaceCenter_MainBoard_Buttons.sch]

Parts:
J40, J41: Conn_01x05_Male; JST_SH_BM05B-SRSS-TB_1x05-1MP_P1.00mm_Vertical
J42: Conn_01x02_Male; PinHeader_1x02_P2.54mm_Vertical
Q1, Q2: DMG1012T-7; SOT-523; MPN DMG1012T-7; Digi-Key_PN DMG1012T-7DICT-ND
R21, R23, R24, R26, R27: 10k; R_0603_1608Metric_Pad1.05x0.95mm_HandSolder
R22, R25: 121; R_0603_1608Metric_Pad1.05x0.95mm_HandSolder

Connections:
+3V3: R21.1, R24.1, R27.1; also elsewhere on the board
+5V: R22.1, R25.1; also elsewhere on the board
BUTTON_L: J40.1, R21.2; also elsewhere on the board
BUTTON_LED_L: Q1.1 (G), R23.1; also elsewhere on the board
BUTTON_LED_R: Q2.1 (G), R26.1; also elsewhere on the board
BUTTON_R: J41.1, R24.2; also elsewhere on the board
GND: J40.2, J41.2, J42.2, Q1.2 (S), Q2.2 (S), R23.2, R26.2; also elsewhere on the board
MODE_SW: J42.1, R27.2; also elsewhere on the board
unnamed: J40.3, R22.2
unnamed: J40.4, Q1.3 (D)
unnamed: J41.3, R25.2
unnamed: J41.4, Q2.3 (D)

Notes on the sheet:
Left/Right Buttons and LEDs
Mode Switch

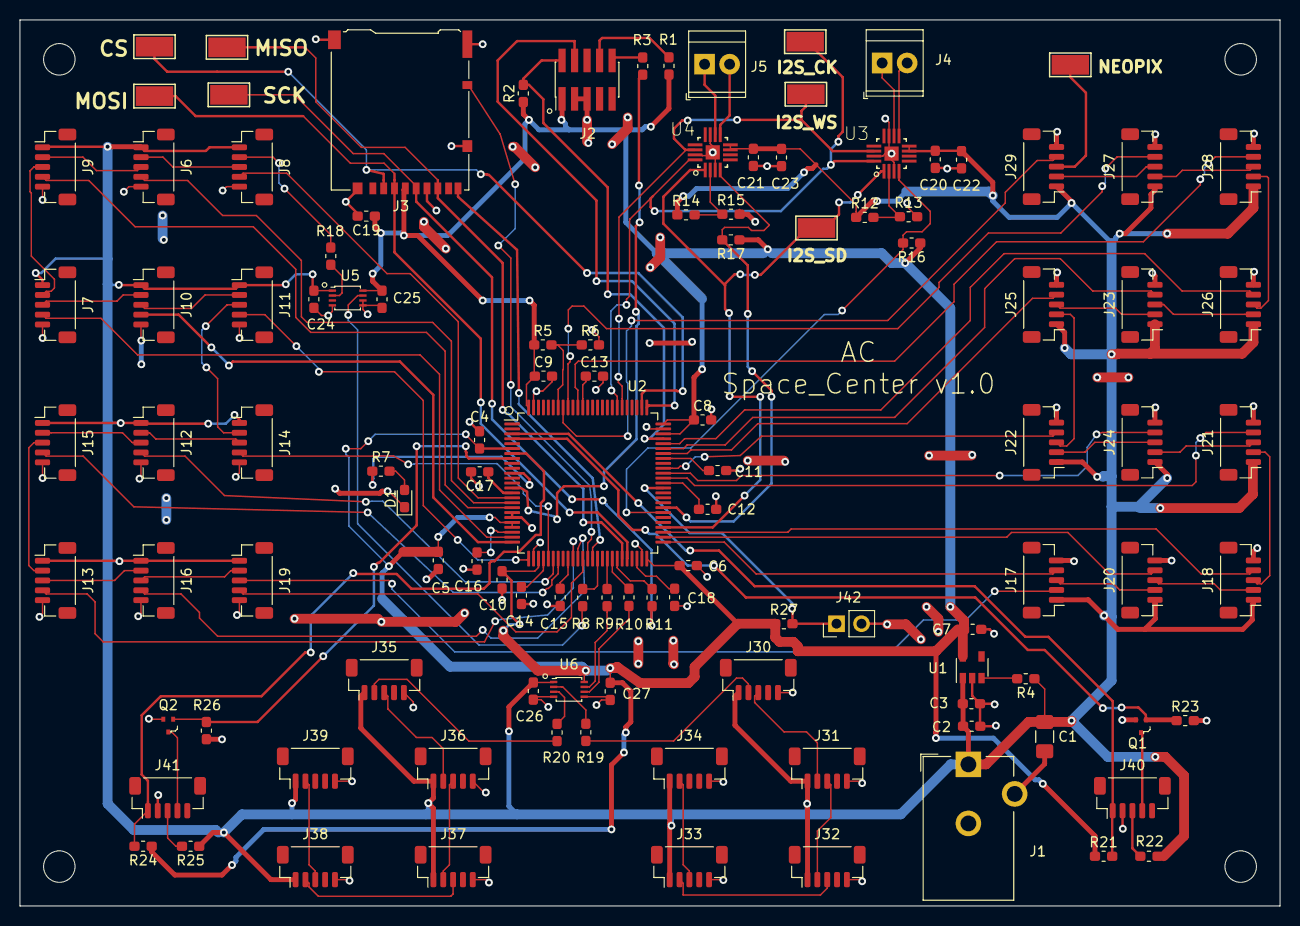
[picture p15: board SpaceCenter_MainBoard_KiCAD.kicad_pcb from above]

Board: 2 copper layers, 128.0 x 90.0 mm, 117 parts (0 on the bottom side), 115 nets.
