carrola1/SpaceCenter/Code/SpaceCenter/Core/Src/main.cpp

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
/* Includes ------------------------------------------------------------------*/
#include "main.h"
/* USER CODE BEGIN Includes */
#include "diskio.h"
#include "ff.h"
#include "wav_player.h"
#include "TouchBoardGroup.hpp"
/* USER CODE END Includes */

/* USER CODE BEGIN PD */
#define NUM_BOARDS 24
/* USER CODE END PD */

I2S_HandleTypeDef hi2s2;
DMA_HandleTypeDef hdma_spi2_tx;

SPI_HandleTypeDef hspi1;
DMA_HandleTypeDef hdma_spi1_rx;
DMA_HandleTypeDef hdma_spi1_tx;

TIM_HandleTypeDef htim2;
DMA_HandleTypeDef hdma_tim2_ch1;
DMA_HandleTypeDef hdma_tim2_ch3;
DMA_HandleTypeDef hdma_tim2_ch4;

/* USER CODE BEGIN PV */
FATFS FatFs;
TouchBoardGroup touchGroup0 = TouchBoardGroup(NUM_BOARDS, htim2, TIM_CHANNEL_1, hdma_tim2_ch1);
std::vector<TouchState_enum> touchStates(NUM_BOARDS);
//NeoPixel rocketStreamL = NeoPixel(68, htim2, TIM_CHANNEL_3, hdma_tim2_ch3);
/* USER CODE END PV */

void SystemClock_Config(void);
static void MX_GPIO_Init(void);
static void MX_DMA_Init(void);
static void MX_I2S2_Init(void);
static void MX_SPI1_Init(void);
static void MX_TIM2_Init(void);
/* USER CODE BEGIN 0 */
// Mount SD Card
/* USER CODE END 0 */

/**
  * @brief  The application entry point.
  * @retval int
  */
int main(void)
{
  /* MCU Configuration--------------------------------------------------------*/

  /* Reset of all peripherals, Initializes the Flash interface and the Systick. */
  HAL_Init();

  /* Configure the system clock */
  SystemClock_Config();

  /* Initialize all configured peripherals */
  MX_GPIO_Init();
  MX_DMA_Init();
  MX_I2S2_Init();
  MX_SPI1_Init();
  MX_TIM2_Init();
  /* USER CODE BEGIN 2 */

  // Mount SD Card
  HAL_GPIO_WritePin(SD_SPI1_CS_N_GPIO_Port, SD_SPI1_CS_N_Pin, GPIO_PIN_SET);
  FRESULT fr;
  fr = f_mount(&FatFs, "", 1);

  HAL_GPIO_WritePin(TEST_LED_GPIO_Port, TEST_LED_Pin, GPIO_PIN_SET);
  HAL_Delay(500);

  /* USER CODE END 2 */

  /* Infinite loop */
  /* USER CODE BEGIN WHILE */
  touchGroup0.setAllPixelColor(0,0,255);
  touchGroup0.showPixels();

  /*
  for (int i=0; i<68; i++) {
    rocketStreamL.setPixelColor(i, 0, 0, 255);
  }
  rocketStreamL.show();
  */

  bool touched = false;
  bool touched_last = false;

  int board_touched = 0;

  while (1)
  {

    touchGroup0.updateTouchStates();
    touchStates = touchGroup0.getTouchStates();

    touched = false;
    for (int i=0; i<NUM_BOARDS; i++) {
      if (touchStates[i] == TOUCHED) {
        touchGroup0.setBoardColor(i, 255, 100, 0);
      } else {
        touchGroup0.setBoardColor(i, 0, 100, 255);
      }
    }
    touchGroup0.showPixels();


    touched_last = touched;

    /*
    if (sw == 0) {
      touchGroup0.setAllPixelColor(255,0,0);
      touchGroup0.showPixels();
      for (int i=0; i<68; i++) {
        rocketStreamL.setPixelColor(i, 255, 0, 0);
      }
      rocketStreamL.show();
    } else {
      touchGroup0.setAllPixelColor(0,255,0);
      touchGroup0.showPixels();
      for (int i=0; i<68; i++) {
        rocketStreamL.setPixelColor(i, 0, 255, 0);
      }
      rocketStreamL.show();
    }
    sw = !sw;
    */


    HAL_Delay(250);


	/* USER CODE END WHILE */

    /* USER CODE BEGIN 3 */
  }
  /* USER CODE END 3 */
}

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
