carrola1/SpaceCenter/Code/SpaceCenter_NucleoTest/Core/Src/main.cpp

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
/* Includes ------------------------------------------------------------------*/
#include "main.h"
#include "touchsensing.h"

/* USER CODE BEGIN Includes */
#include "NeoPixel.hpp"
/* USER CODE END Includes */

TIM_HandleTypeDef htim2;
DMA_HandleTypeDef hdma_tim2_ch1;

TSC_HandleTypeDef htsc;

UART_HandleTypeDef huart2;

/* USER CODE BEGIN PV */
NeoPixel pix = NeoPixel(2);
/* USER CODE END PV */

void SystemClock_Config(void);
static void MX_GPIO_Init(void);
static void MX_DMA_Init(void);
static void MX_USART2_UART_Init(void);
static void MX_TSC_Init(void);
static void MX_TIM2_Init(void);
/**
  * @brief  The application entry point.
  * @retval int
  */
int main(void)
{
  /* MCU Configuration--------------------------------------------------------*/

  /* Reset of all peripherals, Initializes the Flash interface and the Systick. */
  HAL_Init();

  /* Configure the system clock */
  SystemClock_Config();

  /* Initialize all configured peripherals */
  MX_GPIO_Init();
  MX_DMA_Init();
  MX_USART2_UART_Init();
  MX_TSC_Init();
  MX_TOUCHSENSING_Init();
  MX_TIM2_Init();
  /* USER CODE BEGIN 2 */
  tsl_user_Init();

  /* USER CODE END 2 */

  /* Infinite loop */
  /* USER CODE BEGIN WHILE */
  TSL_StateId_enum_T touch_st_last;
  tsl_user_Exec();
  touch_st_last = MyTKeysB[0].p_Data->StateId;
  HAL_GPIO_WritePin(LED_GPIO_Port, LED_Pin, GPIO_PIN_RESET);
  pix.setPixelColor(0, 0, 0, 255);
  pix.setPixelColor(1, 0, 0, 255);
  pix.show();

  while (1)
  {
    /* USER CODE END WHILE */

    /* USER CODE BEGIN 3 */
	tsl_user_Exec();
	if (MyTKeysB[0].p_Data->StateId != touch_st_last) {
		if (MyTKeysB[0].p_Data->StateId == TSL_STATEID_DETECT) {
		  HAL_GPIO_WritePin(LED_GPIO_Port, LED_Pin, GPIO_PIN_SET);
		  pix.setPixelColor(0, 255, 0, 0);
		  pix.setPixelColor(1, 255, 0, 0);
		  pix.show();
		} else if (MyTKeysB[0].p_Data->StateId == TSL_STATEID_RELEASE) {
		  HAL_GPIO_WritePin(LED_GPIO_Port, LED_Pin, GPIO_PIN_RESET);
		  pix.setPixelColor(0, 0, 0, 255);
		  pix.setPixelColor(1, 0, 0, 255);
		  pix.show();
		}
	}
	touch_st_last = MyTKeysB[0].p_Data->StateId;
	HAL_Delay(1);
  }
  /* USER CODE END 3 */
}

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
/* USER CODE BEGIN 4 */
void HAL_TIM_PWM_PulseFinishedHalfCpltCallback(TIM_HandleTypeDef *htim) {
  // DMA buffer set from LED(wr_buf_p) to LED(wr_buf_p + 1)
  if(pix.wr_buf_p < pix.numLEDs) {
    // We're in. Fill the even buffer
    for(uint_fast8_t i = 0; i < 8; ++i) {
      pix.wr_buf[i     ] = pix.PWM_LO << (((pix.pixels[3 * pix.wr_buf_p    ] << i) & 0x80) > 0);
      pix.wr_buf[i +  8] = pix.PWM_LO << (((pix.pixels[3 * pix.wr_buf_p + 1] << i) & 0x80) > 0);
      pix.wr_buf[i + 16] = pix.PWM_LO << (((pix.pixels[3 * pix.wr_buf_p + 2] << i) & 0x80) > 0);
    }
    pix.wr_buf_p++;
  } else if (pix.wr_buf_p < pix.numLEDs + 2) {
    // Last two transfers are resets. 64 * 1.25 us = 80 us == good enough reset
    // First half reset zero fill
    for(uint8_t i = 0; i < pix.WR_BUF_LEN / 2; ++i) pix.wr_buf[i] = 0;
    pix.wr_buf_p++;
  } else {
    HAL_TIM_PWM_Stop_DMA(&htim2, TIM_CHANNEL_1);
  }
}

void HAL_TIM_PWM_PulseFinishedCallback(TIM_HandleTypeDef *htim) {
  // DMA buffer set from LED(wr_buf_p) to LED(wr_buf_p + 1)
  if(pix.wr_buf_p < pix.numLEDs) {
    // We're in. Fill the even buffer
    for(uint_fast8_t i = 0; i < 8; ++i) {
      pix.wr_buf[i + 24] = pix.PWM_LO << (((pix.pixels[3 * pix.wr_buf_p    ] << i) & 0x80) > 0);
      pix.wr_buf[i + 32] = pix.PWM_LO << (((pix.pixels[3 * pix.wr_buf_p + 1] << i) & 0x80) > 0);
      pix.wr_buf[i + 40] = pix.PWM_LO << (((pix.pixels[3 * pix.wr_buf_p + 2] << i) & 0x80) > 0);
    }
    pix.wr_buf_p++;
  } else if (pix.wr_buf_p < pix.numLEDs + 2) {
    // Last two transfers are resets. 64 * 1.25 us = 80 us == good enough reset
    // Second half reset zero fill
    for(uint8_t i = pix.WR_BUF_LEN / 2; i < pix.WR_BUF_LEN; ++i) pix.wr_buf[i] = 0;
    pix.wr_buf_p++;
  } else {
    pix.wr_buf_p = 0;
    HAL_TIM_PWM_Stop_DMA(&htim2, TIM_CHANNEL_1);
  }
}
/* USER CODE END 4 */
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
