carrola1/SpaceCenter/Code/SpaceCenter_NucleoTest_CPP/TOUCHSENSING/App/tsl_user.h

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
/* Define to prevent recursive inclusion -------------------------------------*/
#ifndef __TSL_USER_H
#define __TSL_USER_H

#include "tsl.h"
#include "stm32f0xx_hal.h"

/* Select if you use STMStudio software (0=No, 1=Yes) */
#define USE_STMSTUDIO (0)

#if USE_STMSTUDIO > 0
#include "stmCriticalSection.h"
#define STMSTUDIO_LOCK {enterLock();}
#define STMSTUDIO_UNLOCK {exitLock();}
#else
#define STMSTUDIO_LOCK
#define STMSTUDIO_UNLOCK
#endif

typedef enum
{
  TSL_USER_STATUS_BUSY       = 0, /**< The bank acquisition is on-going */
  TSL_USER_STATUS_OK_NO_ECS  = 1, /**< The bank acquisition is ok, no time for ECS */
  TSL_USER_STATUS_OK_ECS_ON  = 2, /**< The bank acquisition is ok, ECS finished */
  TSL_USER_STATUS_OK_ECS_OFF = 3  /**< The bank acquisition is ok, ECS not executed */
} tsl_user_status_t;

/* Channel IOs definition */
#define CHANNEL_0_IO_MSK    (TSC_GROUP1_IO2)
#define CHANNEL_0_GRP_MSK   (TSC_GROUP1)
#define CHANNEL_0_SRC       (TSC_GROUP1_IDX) /* Index in source register (TSC->IOGXCR[]) */
#define CHANNEL_0_DEST      (0) /* Index in destination result array */

/* Shield IOs definition */
#define SHIELD_IO_MSK      (0)

/* Bank(s) definition */
/* TOUCHKEYS_B bank(s) definition*/
#define BANK_0_NBCHANNELS (1)
#define BANK_0_MSK_CHANNELS   (CHANNEL_0_IO_MSK)
#define BANK_0_MSK_GROUPS     (CHANNEL_0_GRP_MSK)

/* User Parameters */
extern CONST TSL_Bank_T MyBanks[];
extern CONST TSL_TouchKeyB_T MyTKeysB[];
extern CONST TSL_Object_T MyObjects[];
extern TSL_ObjectGroup_T MyObjGroup;

void tsl_user_Init(void);
tsl_user_status_t tsl_user_Exec(void);
void tsl_user_SetThresholds(void);

#endif /* __TSL_USER_H */

/************************ (C) COPYRIGHT STMicroelectronics *****END OF FILE****/
