carrola1/SpaceCenter/(commit log)

2020-08-17 Nucleo project detects touch on breadboard wire
    [SpaceCenter_KiCAD.kicad_pcb, SpaceCenter_KiCAD.sch]
2021-02-16 Working on converting Nucleo project to C++
    [SpaceCenter_MainBoard_Audio.sch, SpaceCenter_MainBoard_BOM.xlsx, SpaceCenter_MainBoard_Buttons.sch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]
2021-03-03 Updated Touch Board with new connector
    [SpaceCenter_TouchBoard_KiCAD.kicad_pcb]
2021-03-19 Debug LED functional. SD Card is communicating. DMA is functional. Getting FDISK_ERROR during mount.
    [HLA_BOM.xlsx]
2021-04-22 Fixed NeoPixel incorrect color issue. Updated touch thresholds based on testing with actual environment.
    [NeoPixel.cpp, NeoPixel.hpp, SpaceCenter.ioc, TouchBoardGroup.cpp, TouchBoardGroup.hpp, main.cpp, tsl_conf.h]
2021-05-04 TouchBoard updated and ordered
    [HLA_BOM.ods, SpaceCenter_TouchBoard_BOM.csv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]
2021-05-17 Updated HLA BOM and exported TouchBoard 3D files
    [HLA_BOM.ods, SpaceCenter_TouchBoard.stl, SpaceCenter_TouchBoard_KiCAD.kicad_pcb, SpaceCenter_TouchBoard_KiCAD.step]
2021-06-10 Adding rocket prints. Added PWM driver support for rocket LEDs.
    [Space Center Star.3mf, Space Center Star.stl, SpaceCenter Rocket Stream LED Holder.stl, SpaceCenter Rocket.stl]
2021-08-10 All 48 LEDs working
    Had to remove DMA circular buffer and change to a one shot. Was not able to update the buffer quite fast enough to beat the DMA. Moving to a 48MHz clock would likely fix this.
    [SpaceCenter Rocket Tall.stl, SpaceCenter Rocket.stl]
2021-08-12 Made 3 touch banks of 8 channels each,
    IO1's, IO2', IO3's grouped together in banks. Channels are still in order of neopixels. Doesn't work too well.
    [SpaceCenter.ioc, TouchBoardGroup.cpp, TouchBoardGroup.hpp, tsl_conf.h, tsl_user.h]
2021-09-03 All touch sensors working and mapped properly
    Made 3 touch groups that include 8 channels each, all 8 in different banks.
    [SpaceCenter_TouchBoard.stl, SpaceCenter_TouchBoard_BOM.csv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]
2021-09-09 Discrete touch sensor interface implemented
    Currently getting a build error (can't find function f_mount)
    [SpaceCenter.ioc, TouchBoard.cpp, TouchBoard.hpp, TouchBoardGroup.cpp, TouchBoardGroup.hpp, TouchGpioMap.h, main.cpp, main.h]
2021-09-12 Touch Board rev 2.0 Working Great
    [SpaceCenter_TouchBoard_KiCAD.kicad_pcb, SpaceCenter_TouchBoard_KiCAD.sch]
2021-10-01 Touch Board 2.0 Fab Files
    [SpaceCenter_TouchBoard_BOM.csv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]
