carrola1/SpaceCenter/(notices)

Notices in the files:
Code/SpaceCenter_NucleoTest/Core/Src/main.cpp:
© Copyright (c) 2020 STMicroelectronics.
All rights reserved.
This software component is licensed by ST under BSD 3-Clause license,
the "License"; You may not use this file except in compliance with the
License. You may obtain a copy of the License at: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
Code/SpaceCenter_NucleoTest_CPP/TOUCHSENSING/App/tsl_user.h:
This software component is licensed by ST under Ultimate Liberty license
Code/SpaceCenter/Core/Src/main.cpp:
© Copyright (c) 2021 STMicroelectronics.
parts and their libraries:
Copyright 2021 Accelerated Designs. All rights reserved.
